subbuu-aadhii/Ultra-Low-gm-OTAs-for-a-Tunable-50-60-Hz-OTA-C-Notch-Filter-SkyWater-130-nm/notch_ota_bulk_driven/screenshots/11_pre_vs_post_layout.png

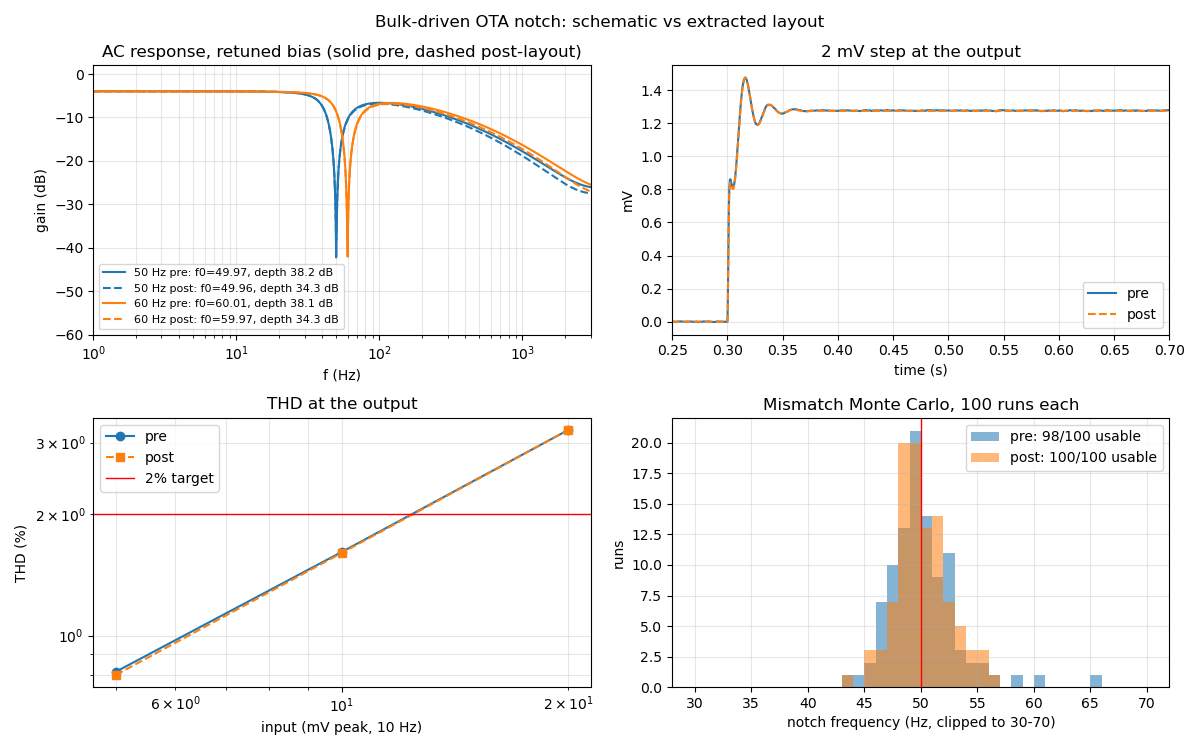
notch_ota_bulk_driven/screenshots/11_pre_vs_post_layout.png
