subbuu-aadhii/Ultra-Low-gm-OTAs-for-a-Tunable-50-60-Hz-OTA-C-Notch-Filter-SkyWater-130-nm/notch_ota_current_cancellation/screenshots/05_notch_transient.png

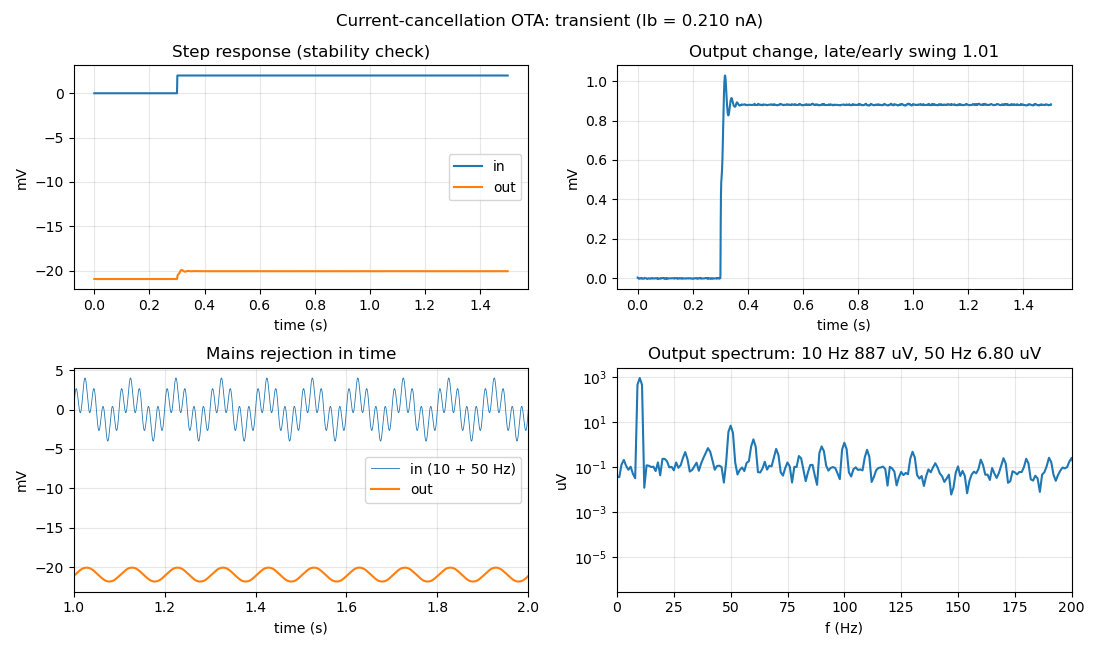
notch_ota_current_cancellation/screenshots/05_notch_transient.png
