subbuu-aadhii/Ultra-Low-gm-OTAs-for-a-Tunable-50-60-Hz-OTA-C-Notch-Filter-SkyWater-130-nm/notch_ota_current_cancellation/screenshots/06_monte_carlo_mismatch.png

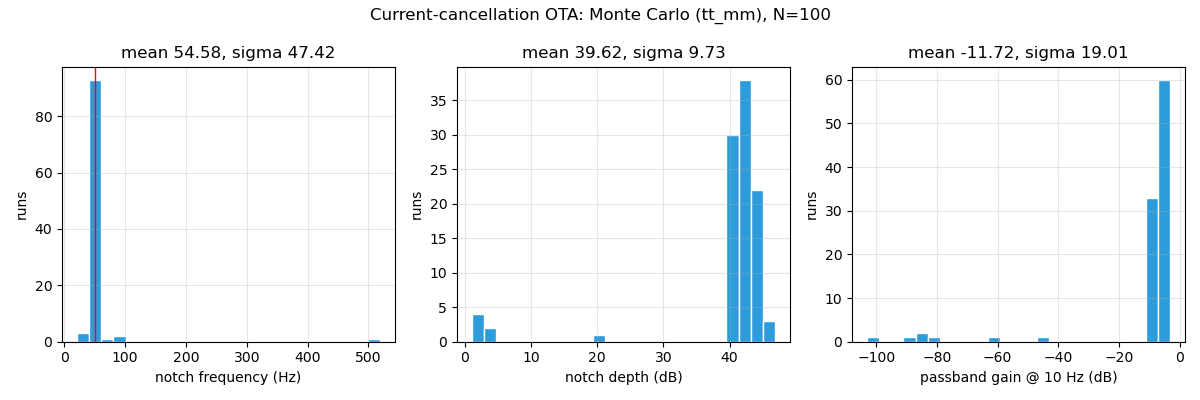
notch_ota_current_cancellation/screenshots/06_monte_carlo_mismatch.png
