subbuu-aadhii/Ultra-Low-gm-OTAs-for-a-Tunable-50-60-Hz-OTA-C-Notch-Filter-SkyWater-130-nm/paper/figures_white/ota_cc.png

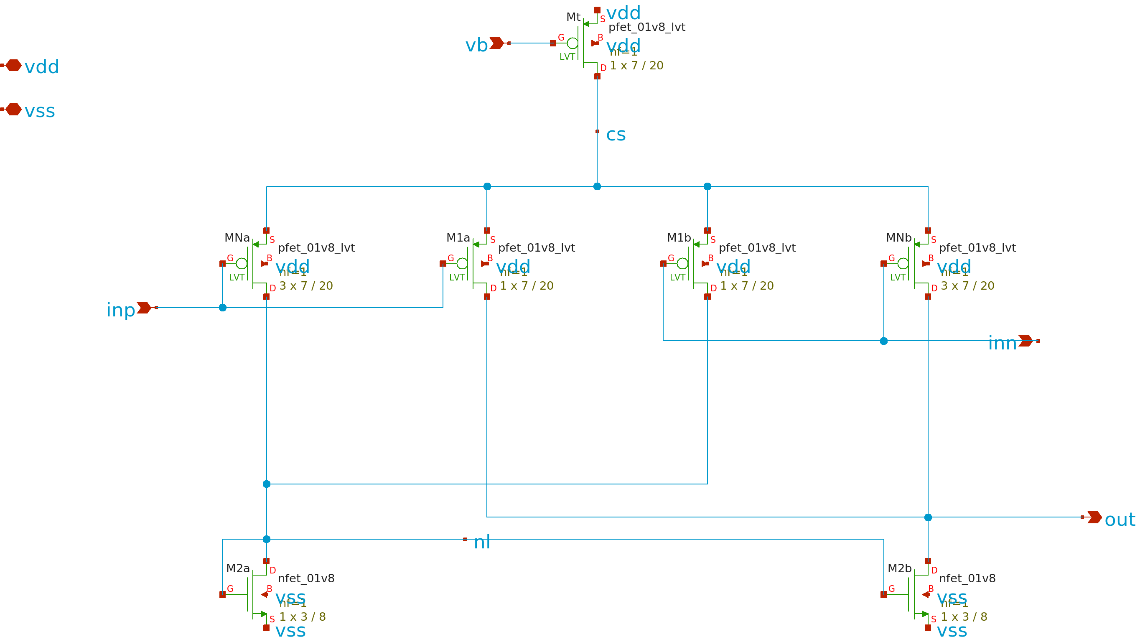
paper/figures_white/ota_cc.png
