subbuu-aadhii/Ultra-Low-gm-OTAs-for-a-Tunable-50-60-Hz-OTA-C-Notch-Filter-SkyWater-130-nm/notch_ota_bulk_driven/simulations/tr_step.txt

 0.00000000e+00  0.00000000e+00  0.00000000e+00  4.33778838e-02  0.00000000e+00  4.39656278e-02  0.00000000e+00  2.58305479e-02  0.00000000e+00  9.28008067e-03 
 5.00000000e-06  0.00000000e+00  5.00000000e-06  4.33778867e-02  5.00000000e-06  4.39656242e-02  5.00000000e-06  2.58305446e-02  5.00000000e-06  9.28007895e-03 
 1.00000000e-05  0.00000000e+00  1.00000000e-05  4.33778848e-02  1.00000000e-05  4.39656166e-02  1.00000000e-05  2.58305374e-02  1.00000000e-05  9.28007645e-03 
 2.00000000e-05  0.00000000e+00  2.00000000e-05  4.33778764e-02  2.00000000e-05  4.39655952e-02  2.00000000e-05  2.58305167e-02  2.00000000e-05  9.28007109e-03 
 4.00000000e-05  0.00000000e+00  4.00000000e-05  4.33778431e-02  4.00000000e-05  4.39655412e-02  4.00000000e-05  2.58304681e-02  4.00000000e-05  9.28006141e-03 
 8.00000000e-05  0.00000000e+00  8.00000000e-05  4.33777535e-02  8.00000000e-05  4.39654770e-02  8.00000000e-05  2.58304174e-02  8.00000000e-05  9.28004142e-03 
 1.60000000e-04  0.00000000e+00  1.60000000e-04  4.33776168e-02  1.60000000e-04  4.39653975e-02  1.60000000e-04  2.58303384e-02  1.60000000e-04  9.27998677e-03 
 3.20000000e-04  0.00000000e+00  3.20000000e-04  4.33771963e-02  3.20000000e-04  4.39650578e-02  3.20000000e-04  2.58299589e-02  3.20000000e-04  9.27981280e-03 
 6.40000000e-04  0.00000000e+00  6.40000000e-04  4.33761078e-02  6.40000000e-04  4.39642288e-02  6.40000000e-04  2.58290506e-02  6.40000000e-04  9.27950537e-03 
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
 1.41400000e-02  0.00000000e+00  1.41400000e-02  4.33783304e-02  1.41400000e-02  4.39659932e-02  1.41400000e-02  2.58280127e-02  1.41400000e-02  9.28094119e-03 
 1.46400000e-02  0.00000000e+00  1.46400000e-02  4.33779922e-02  1.46400000e-02  4.39656364e-02  1.46400000e-02  2.58274984e-02  1.46400000e-02  9.28116136e-03 
 1.51400000e-02  0.00000000e+00  1.51400000e-02  4.33772629e-02  1.51400000e-02  4.39651500e-02  1.51400000e-02  2.58271966e-02  1.51400000e-02  9.28104015e-03 
 1.56400000e-02  0.00000000e+00  1.56400000e-02  4.33771432e-02  1.56400000e-02  4.39650319e-02  1.56400000e-02  2.58270432e-02  1.56400000e-02  9.28072870e-03 
 1.61400000e-02  0.00000000e+00  1.61400000e-02  4.33760650e-02  1.61400000e-02  4.39641880e-02  1.61400000e-02  2.58259703e-02  1.61400000e-02  9.28058400e-03 
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
