subbuu-aadhii/Ultra-Low-gm-OTAs-for-a-Tunable-50-60-Hz-OTA-C-Notch-Filter-SkyWater-130-nm/notch_ota_current_cancellation/simulations/tr_step.txt

 0.00000000e+00  0.00000000e+00  0.00000000e+00 -2.09302800e-02  0.00000000e+00 -1.87740498e-02  0.00000000e+00 -1.12052500e-02  0.00000000e+00 -3.74538345e-03 
 5.00000000e-06  0.00000000e+00  5.00000000e-06 -2.09302742e-02  5.00000000e-06 -1.87740373e-02  5.00000000e-06 -1.12052373e-02  5.00000000e-06 -3.74538361e-03 
 1.00000000e-05  0.00000000e+00  1.00000000e-05 -2.09302652e-02  1.00000000e-05 -1.87740318e-02  1.00000000e-05 -1.12052335e-02  1.00000000e-05 -3.74538044e-03 
 2.00000000e-05  0.00000000e+00  2.00000000e-05 -2.09302529e-02  2.00000000e-05 -1.87740289e-02  2.00000000e-05 -1.12052346e-02  2.00000000e-05 -3.74537534e-03 
 4.00000000e-05  0.00000000e+00  4.00000000e-05 -2.09302537e-02  4.00000000e-05 -1.87740393e-02  4.00000000e-05 -1.12052520e-02  4.00000000e-05 -3.74536462e-03 
 8.00000000e-05  0.00000000e+00  8.00000000e-05 -2.09303019e-02  8.00000000e-05 -1.87740994e-02  8.00000000e-05 -1.12053127e-02  8.00000000e-05 -3.74531283e-03 
 1.60000000e-04  0.00000000e+00  1.60000000e-04 -2.09305028e-02  1.60000000e-04 -1.87743447e-02  1.60000000e-04 -1.12055226e-02  1.60000000e-04 -3.74516206e-03 
 3.20000000e-04  0.00000000e+00  3.20000000e-04 -2.09306900e-02  3.20000000e-04 -1.87745181e-02  3.20000000e-04 -1.12055894e-02  3.20000000e-04 -3.74491076e-03 
 6.40000000e-04  0.00000000e+00  6.40000000e-04 -2.09309864e-02  6.40000000e-04 -1.87748711e-02  6.40000000e-04 -1.12053934e-02  6.40000000e-04 -3.74411784e-03 
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
 1.41400000e-02  0.00000000e+00  1.41400000e-02 -2.09348862e-02  1.41400000e-02 -1.87792753e-02  1.41400000e-02 -1.12105117e-02  1.41400000e-02 -3.74937672e-03 
 1.46400000e-02  0.00000000e+00  1.46400000e-02 -2.09344693e-02  1.46400000e-02 -1.87788183e-02  1.46400000e-02 -1.12100020e-02  1.46400000e-02 -3.74907467e-03 
 1.51400000e-02  0.00000000e+00  1.51400000e-02 -2.09347821e-02  1.51400000e-02 -1.87791817e-02  1.51400000e-02 -1.12101470e-02  1.51400000e-02 -3.74859377e-03 
 1.56400000e-02  0.00000000e+00  1.56400000e-02 -2.09347304e-02  1.56400000e-02 -1.87790996e-02  1.56400000e-02 -1.12099550e-02  1.56400000e-02 -3.74810620e-03 
 1.61400000e-02  0.00000000e+00  1.61400000e-02 -2.09340912e-02  1.61400000e-02 -1.87783870e-02  1.61400000e-02 -1.12093539e-02  1.61400000e-02 -3.74771604e-03 
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
