subbuu-aadhii/Ultra-Low-gm-OTAs-for-a-Tunable-50-60-Hz-OTA-C-Notch-Filter-SkyWater-130-nm/notch_ota_current_division/simulations/tr_step.txt

 0.00000000e+00  0.00000000e+00  0.00000000e+00 -6.04712750e-02  0.00000000e+00 -6.52387592e-02  0.00000000e+00 -3.86909792e-02  0.00000000e+00 -1.15401699e-02 
 5.00000000e-06  0.00000000e+00  5.00000000e-06 -6.04712882e-02  5.00000000e-06 -6.52387776e-02  5.00000000e-06 -3.86909972e-02  5.00000000e-06 -1.15401688e-02 
 1.00000000e-05  0.00000000e+00  1.00000000e-05 -6.04713000e-02  1.00000000e-05 -6.52387991e-02  1.00000000e-05 -3.86910192e-02  1.00000000e-05 -1.15401674e-02 
 2.00000000e-05  0.00000000e+00  2.00000000e-05 -6.04713324e-02  2.00000000e-05 -6.52388383e-02  2.00000000e-05 -3.86910562e-02  2.00000000e-05 -1.15401656e-02 
 4.00000000e-05  0.00000000e+00  4.00000000e-05 -6.04713975e-02  4.00000000e-05 -6.52389101e-02  4.00000000e-05 -3.86911204e-02  4.00000000e-05 -1.15401562e-02 
 8.00000000e-05  0.00000000e+00  8.00000000e-05 -6.04714863e-02  8.00000000e-05 -6.52390328e-02  8.00000000e-05 -3.86912392e-02  8.00000000e-05 -1.15401193e-02 
 1.60000000e-04  0.00000000e+00  1.60000000e-04 -6.04716342e-02  1.60000000e-04 -6.52391884e-02  1.60000000e-04 -3.86913805e-02  1.60000000e-04 -1.15400427e-02 
 3.20000000e-04  0.00000000e+00  3.20000000e-04 -6.04721271e-02  3.20000000e-04 -6.52398052e-02  3.20000000e-04 -3.86919439e-02  3.20000000e-04 -1.15399067e-02 
 6.40000000e-04  0.00000000e+00  6.40000000e-04 -6.04727563e-02  6.40000000e-04 -6.52405290e-02  6.40000000e-04 -3.86926685e-02  6.40000000e-04 -1.15396951e-02 
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
 1.41400000e-02  0.00000000e+00  1.41400000e-02 -6.04648898e-02  1.41400000e-02 -6.52310974e-02  1.41400000e-02 -3.86896461e-02  1.41400000e-02 -1.15299478e-02 
 1.46400000e-02  0.00000000e+00  1.46400000e-02 -6.04652491e-02  1.46400000e-02 -6.52315253e-02  1.46400000e-02 -3.86901806e-02  1.46400000e-02 -1.15301846e-02 
 1.51400000e-02  0.00000000e+00  1.51400000e-02 -6.04654611e-02  1.51400000e-02 -6.52317748e-02  1.51400000e-02 -3.86905399e-02  1.51400000e-02 -1.15303201e-02 
 1.56400000e-02  0.00000000e+00  1.56400000e-02 -6.04652395e-02  1.56400000e-02 -6.52315075e-02  1.56400000e-02 -3.86906279e-02  1.56400000e-02 -1.15307515e-02 
 1.61400000e-02  0.00000000e+00  1.61400000e-02 -6.04651570e-02  1.61400000e-02 -6.52314141e-02  1.61400000e-02 -3.86907735e-02  1.61400000e-02 -1.15312465e-02 
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
