subbuu-aadhii/Ultra-Low-gm-OTAs-for-a-Tunable-50-60-Hz-OTA-C-Notch-Filter-SkyWater-130-nm/notch_ota_bulk_driven/screenshots/02_notch_testbench.png

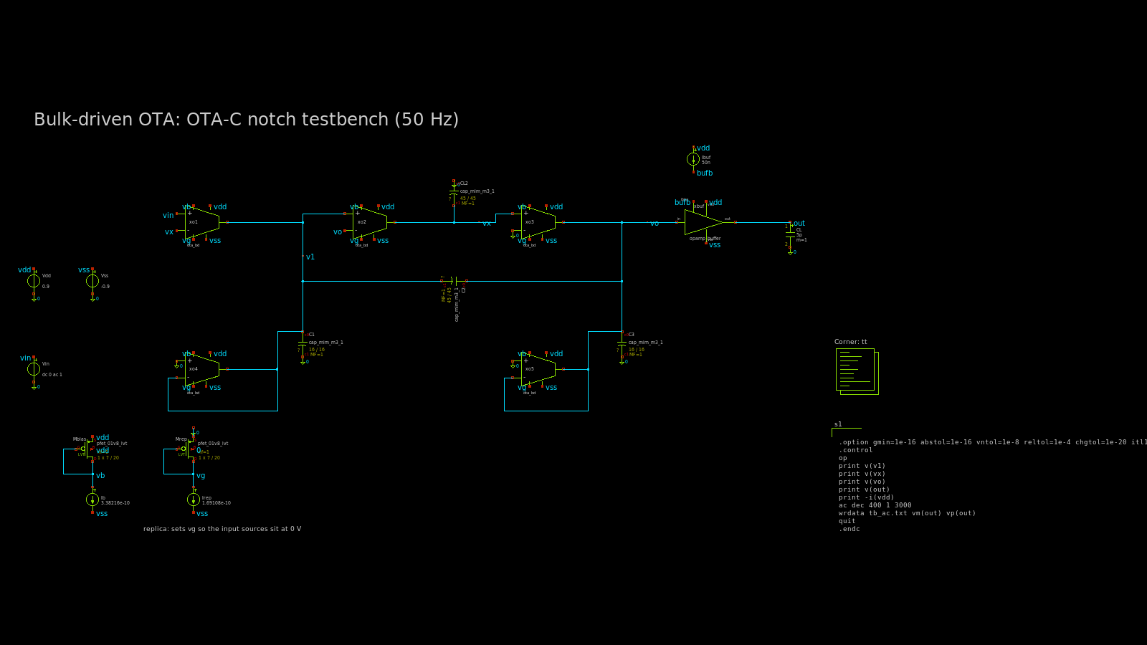
notch_ota_bulk_driven/screenshots/02_notch_testbench.png
