subbuu-aadhii/Ultra-Low-gm-OTAs-for-a-Tunable-50-60-Hz-OTA-C-Notch-Filter-SkyWater-130-nm/notch_ota_bulk_driven/layout/ota_bd_lvs.spice

* NGSPICE file created from ota_bd.ext - technology: sky130A

.subckt ota_bd inp inn out vb vg vdd vss
X0 a_400_n2506# vg a_6200_0# inn sky130_fd_pr__pfet_01v8_lvt ad=2.03 pd=14.58 as=2.03 ps=14.58 w=7 l=20
X1 a_4240_n2506# vg a_6200_0# inp sky130_fd_pr__pfet_01v8_lvt ad=2.03 pd=14.58 as=2.03 ps=14.58 w=7 l=20
X2 out a_0_n26# vdd vdd sky130_fd_pr__pfet_01v8_lvt ad=0.87 pd=6.58 as=0.87 ps=6.58 w=3 l=8
X3 a_400_n2506# a_400_n2506# vss vss sky130_fd_pr__nfet_01v8 ad=0.87 pd=6.58 as=0.87 ps=6.58 w=3 l=8
X4 out a_4240_n2506# vss vss sky130_fd_pr__nfet_01v8 ad=0.87 pd=6.58 as=0.87 ps=6.58 w=3 l=8
X5 a_6200_0# vb vdd vdd sky130_fd_pr__pfet_01v8_lvt ad=2.03 pd=14.58 as=2.03 ps=14.58 w=7 l=20
X6 a_0_n26# a_400_n2506# vss vss sky130_fd_pr__nfet_01v8 ad=0.87 pd=6.58 as=0.87 ps=6.58 w=3 l=8
X7 a_4240_n2506# a_4240_n2506# vss vss sky130_fd_pr__nfet_01v8 ad=0.87 pd=6.58 as=0.87 ps=6.58 w=3 l=8
X8 a_0_n26# a_0_n26# vdd vdd sky130_fd_pr__pfet_01v8_lvt ad=0.87 pd=6.58 as=0.87 ps=6.58 w=3 l=8
.ends
